DrFlGd/Stackable-Bin-Workshop/(commit log)

2026-09-26 Add parametric stackable bin generator
    [stackable_bin.scad]
2026-09-26 Add assembly render
2026-09-26 Make stack registration cutter-safe
    [stackable_bin.scad]
2026-09-27 Restore smooth cutter-safe stack registration
    [stackable_bin.scad]
2026-09-27 Add optional top and hinged front lid
    [stackable_bin.scad]
2026-09-27 Polish optional closure parameters
    [stackable_bin.scad]
2026-10-31 Fix part collisions and rework lid fit (#1)
    - Lid: hinge axis on the lid's outer edge, lid closes onto the front
    panel's top end face, side profile follows the lid's outer face
    - Bottom panel starts behind the front panel's square-cut end
    - Top panel recessed below the rim so its mortise and reliefs stay
    clear of the stacking keys
    - Mortises get length clearance; stacking keys get their own
    stack_clearance
    - Add fit_coupon and fit_check outputs, stacked lid opening limit,
    tools/fit_check.py and a CI workflow
    Claude-Session: https://claude.ai/code/session_01WPYFun85oVoY32wYx59gsP
    [stackable_bin.scad]
